frood1168/hackrf-pro/(list of files, drawings)

Other design files:
Altium/Imported praline/adc-dac.SchDoc
Altium/Imported praline/baseband.SchDoc
Altium/Imported praline/clock.SchDoc
Altium/Imported praline/fpga.SchDoc
Altium/Imported praline/frontend.SchDoc
Altium/Imported praline/image_reject.SchDoc
Altium/Imported praline/mcu.SchDoc
Altium/Imported praline/mcu_c18pf.SchDoc
Altium/Imported praline/mixer.SchDoc
Altium/Imported praline/power.SchDoc
Altium/Imported praline/praline1/praline.PcbLib
Altium/Imported praline/praline1/praline.SCHLIB
Altium/Imported praline/praline.PcbDoc
Altium/Imported praline/praline.PrjPcb
Altium/Imported praline/praline.SchDoc
Altium/Imported praline/switch_control.SchDoc
Altium/Imported praline/usb.SchDoc
Altium/Imported praline_01/adc-dac.SchDoc
Altium/Imported praline_01/baseband.SchDoc
Altium/Imported praline_01/clock.SchDoc
Altium/Imported praline_01/fpga.SchDoc
Altium/Imported praline_01/frontend.SchDoc
Altium/Imported praline_01/image_reject.SchDoc
Altium/Imported praline_01/mcu.SchDoc
Altium/Imported praline_01/mixer.SchDoc
Altium/Imported praline_01/power.SchDoc
Altium/Imported praline_01/praline-cache.SchLib
Altium/Imported praline_01/praline.PcbDoc
Altium/Imported praline_01/praline.PrjPcb
Altium/Imported praline_01/praline.SchDoc
Altium/Imported praline_01/praline.SchLib
Altium/Imported praline_01/switch_control.SchDoc
Altium/Imported praline_01/usb.SchDoc
