frood1168/hackrf-pro/adc-dac.kicad_sch

## KiCad design adc-dac.kicad_sch (2026-06-23)

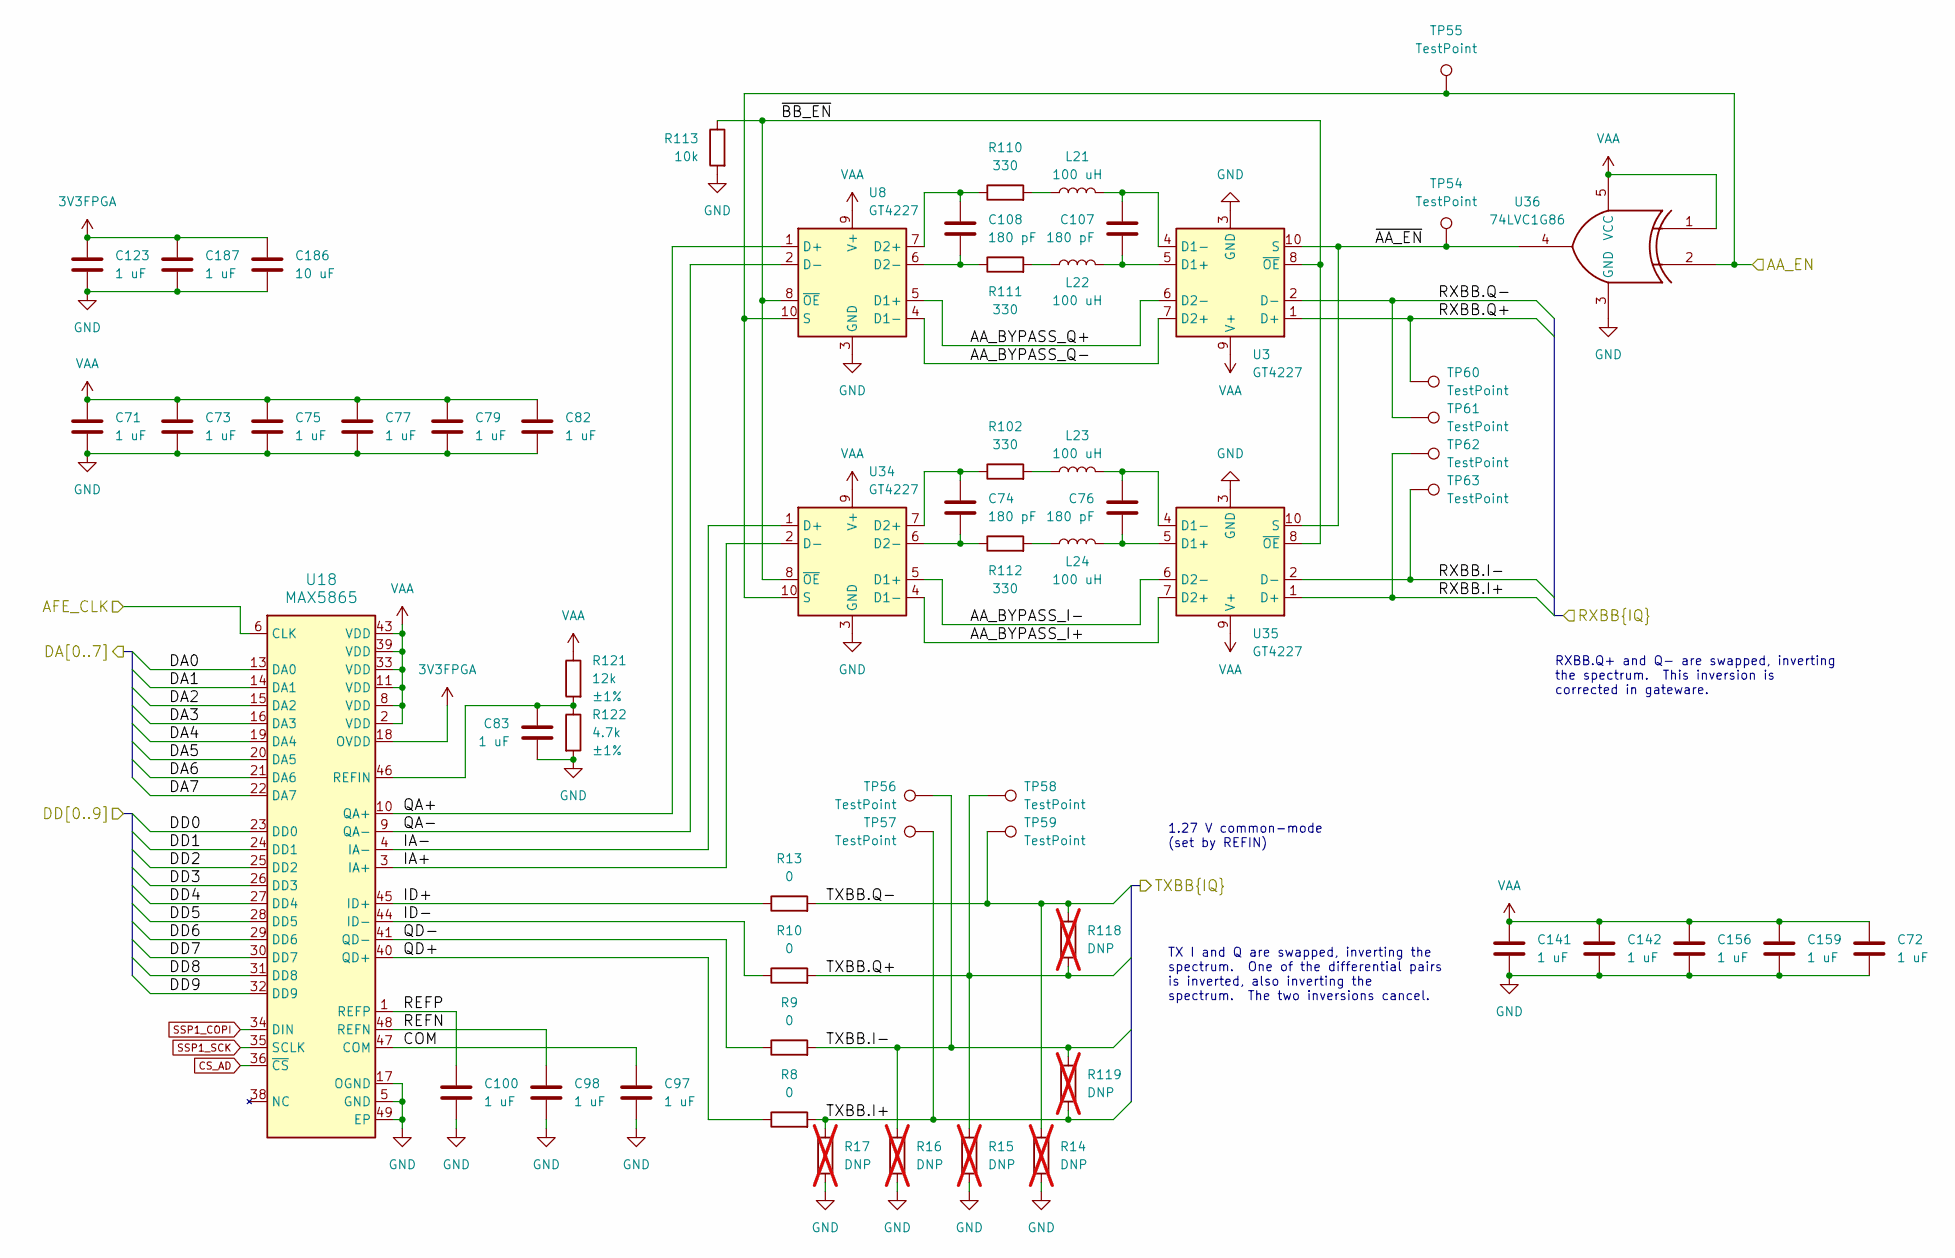
[picture p1: schematic adc-dac.kicad_sch]

Parts:
C71, C72, C73, C75, C77, C79, C82, C83, C97, C98, C100, C123, C141, C142, C156, C159, C187: 1 uF; C_0201_0603Metric; Part Number GRM033R61A105ME44D
C74, C76, C107, C108: 180 pF; C_0201_0603Metric; Part Number GRM0335C1H181JA01D
C186: 10 uF; C_0805_2012Metric; Part Number CL21A106KOQNNNE
L21, L22, L23, L24: 100 uH; L_TDK_MLZ2012_h1.25mm; Part Number MLZ2012N101LT000
R8, R9, R10, R13: 0; R_0201_0603Metric; Part Number RC0201JR-070RL
R14, R15, R16, R17, R118, R119: DNP; R_0201_0603Metric; not fitted
R102, R110, R111, R112: 330; R_0201_0603Metric; Part Number RC0201JR-07330RL
R113: 10k; R_0402_1005Metric; Part Number RC0402JR-0710KL
R121: 12k; R_0201_0603Metric; Tolerance ±1%; Part Number RC0201FR-0712KL
R122: 4.7k; R_0201_0603Metric; Tolerance ±1%; Part Number RC0201FR-074K7L
TP54, TP55, TP56, TP57, TP58, TP59, TP60, TP61, TP62, TP63: TestPoint; TestPoint_Pad_D1.0mm
U3, U8, U34, U35: GT4227; GTIC_UQFN-10_1.4x1.8mm_P0.4mm; Part Number GT4227QA
U18: MAX5865; QFN-48-1EP_7x7mm_P0.5mm_EP5.3x5.3mm_ThermalVias; Part Number MAX5865ETM+T
U36: 74LVC1G86; SOT-353_SC-70-5; Part Number SN74LVC1G86DCKR

Connections:
3V3FPGA: C123.1, C186.1, C187.1, U18.18 (OVDD)
AA_BYPASS_I+: U34.4 (D1-), U35.7 (D2+)
AA_BYPASS_I-: U34.5 (D1+), U35.6 (D2-)
AA_BYPASS_Q+: U3.6 (D2-), U8.5 (D1+)
AA_BYPASS_Q-: U3.7 (D2+), U8.4 (D1-)
AA_EN: TP55.1, U8.10 (S), U34.10 (S), U36.2
AFE_CLK: U18.6 (CLK)
COM: C97.1, U18.47 (COM)
CS_AD: U18.36 (~CS)
DA0: U18.13 (DA0)
DA1: U18.14 (DA1)
DA2: U18.15 (DA2)
DA3: U18.16 (DA3)
DA4: U18.19 (DA4)
DA5: U18.20 (DA5)
DA6: U18.21 (DA6)
DA7: U18.22 (DA7)
DD0: U18.23 (DD0)
DD1: U18.24 (DD1)
DD2: U18.25 (DD2)
DD3: U18.26 (DD3)
DD4: U18.27 (DD4)
DD5: U18.28 (DD5)
DD6: U18.29 (DD6)
DD7: U18.30 (DD7)
DD8: U18.31 (DD8)
DD9: U18.32 (DD9)
GND: C71.2, C72.2, C73.2, C75.2, C77.2, C79.2, C82.2, C83.2, C97.2, C98.2, C100.2, C123.2, C141.2, C142.2, C156.2, C159.2, C186.2, C187.2, R14.2, R15.2, R16.2, R17.2, R113.2, R122.2, U3.3 (GND), U8.3 (GND), U18.5 (GND), U18.7 (GND), U18.12 (GND), U18.17 (OGND), U18.37 (GND), U18.42 (GND), U18.49 (EP), U34.3 (GND), U35.3 (GND), U36.3 (GND)
IA+: U18.3 (IA+), U34.2 (D-)
IA-: U18.4 (IA-), U34.1 (D+)
ID+: R13.1, U18.45 (ID+)
ID-: R10.1, U18.44 (ID-)
unnamed: C74.1, R102.1, U34.7 (D2+)
unnamed: C74.2, R112.1, U34.6 (D2-)
unnamed: C76.1, L23.2, U35.4 (D1-)
unnamed: C76.2, L24.2, U35.5 (D1+)
unnamed: C83.1, R121.2, R122.1, U18.46 (REFIN)
unnamed: C107.1, L21.2, U3.4 (D1-)
unnamed: C107.2, L22.2, U3.5 (D1+)
unnamed: C108.1, R110.1, U8.7 (D2+)
unnamed: C108.2, R111.1, U8.6 (D2-)
unnamed: L21.1, R110.2
unnamed: L22.1, R111.2
unnamed: L23.1, R102.2
unnamed: L24.1, R112.2
QA+: U8.1 (D+), U18.10 (QA+)
QA-: U8.2 (D-), U18.9 (QA-)
QD+: R8.1, U18.40 (QD+)
QD-: R9.1, U18.41 (QD-)
REFN: C98.1, U18.48 (REFN)
REFP: C100.1, U18.1 (REFP)
RXBB.I+: TP62.1, U35.1 (D+)
RXBB.I-: TP63.1, U35.2 (D-)
RXBB.Q+: TP60.1, U3.1 (D+)
RXBB.Q-: TP61.1, U3.2 (D-)
SSP1_COPI: U18.34 (DIN)
SSP1_SCK: U18.35 (SCLK)
TXBB.I+: R8.2, R17.1, R119.2, TP57.1
TXBB.I-: R9.2, R16.1, R119.1, TP56.1
TXBB.Q+: R10.2, R15.1, R118.2, TP58.1
TXBB.Q-: R13.2, R14.1, R118.1, TP59.1
VAA: C71.1, C72.1, C73.1, C75.1, C77.1, C79.1, C82.1, C141.1, C142.1, C156.1, C159.1, R121.1, U3.9 (V+), U8.9 (V+), U18.2 (VDD), U18.8 (VDD), U18.11 (VDD), U18.33 (VDD), U18.39 (VDD), U18.43 (VDD), U34.9 (V+), U35.9 (V+), U36.1, U36.5 (VCC)
~AA_EN: TP54.1, U3.10 (S), U35.10 (S), U36.4
~BB_EN: R113.1, U3.8 (~OE), U8.8 (~OE), U34.8 (~OE), U35.8 (~OE)

Notes on the sheet:
1.27 V common-mode (set by REFIN)
RXBB.Q+ and Q- are swapped, inverting the spectrum. This inversion is corrected in gateware.
TX I and Q are swapped, inverting the spectrum. One of the differential pairs is inverted, also inverting the spectrum. The two inversions cancel.
