frood1168/hackrf-pro/baseband.kicad_sch

## KiCad design baseband.kicad_sch (2026-06-23)

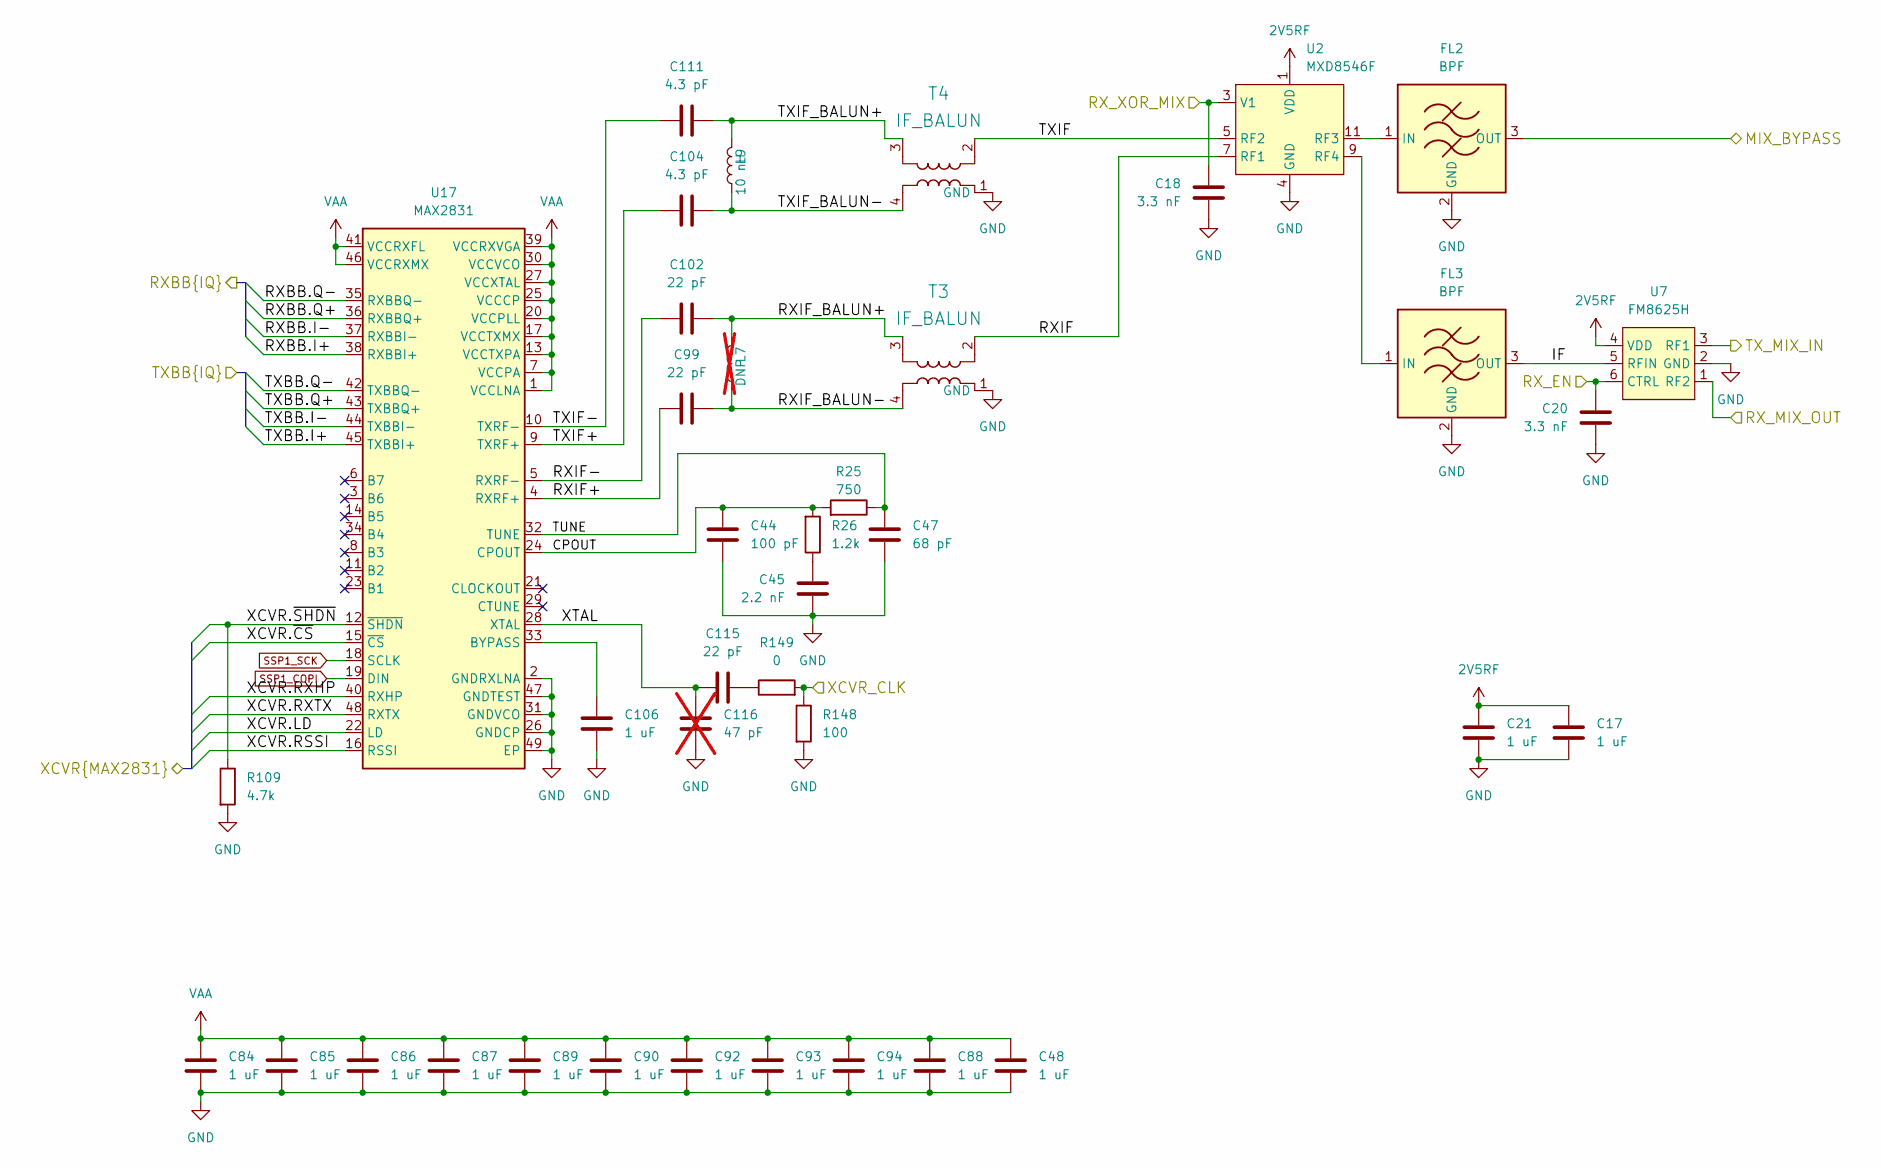
[picture p2: schematic baseband.kicad_sch]

Parts:
C17, C21, C48, C84, C85, C86, C87, C88, C89, C90, C92, C93, C94, C106: 1 uF; C_0201_0603Metric; Part Number GRM033R61A105ME44D
C18, C20: 3.3 nF; C_0201_0603Metric; Part Number GRM033R71A332KA01D
C44: 100 pF; C_0201_0603Metric; Part Number GRM0335C1E101JA01D
C45: 2.2 nF; C_0201_0603Metric; Part Number GRM033R71A222KA01D
C47: 68 pF; C_0201_0603Metric; Part Number GRM0335C1H680JA01D
C99, C102, C115: 22 pF; C_0201_0603Metric; Part Number GRM0335C1H220JA01D
C104, C111: 4.3 pF; C_0201_0603Metric; Part Number GRM0335C1E4R3CA01D
C116: 47 pF; C_0201_0603Metric; Part Number GRM0335C1E470JA01D; not fitted
FL2, FL3: BPF; Filter_Pulse_BPF1608LM09R5000A; Part Number BPF1608LM02R2400A
L7: DNP; L_0201_0603Metric; not fitted
L9: 10 nH; L_0201_0603Metric; Part Number LQP03TN10NJ02D
R25: 750; R_0201_0603Metric; Part Number RC0201JR-07750RL
R26: 1.2k; R_0201_0603Metric; Part Number RC0201JR-071K2L
R109: 4.7k; R_0201_0603Metric; Part Number RC0201FR-074K7L
R148: 100; R_0201_0603Metric; Part Number RC0201JR-07100RL
R149: 0; R_0201_0603Metric; Part Number RC0201JR-070RL
T3, T4: IF_BALUN; Balun_TDK_TFSZ06052460-3310A2X; Part Number TFSZ06052460-3310A2X
U2: MXD8546F; QFN-12-1EP_2x2mm_P0.5mm_EP1x1mm; Part Number MXD8546F
U7: FM8625H; TSLP-6-4_1.1x0.7mm_P0.4mm; Part Number FM8625H
U17: MAX2831; QFN-48-1EP_7x7mm_P0.5mm_EP5.6x5.6mm_ThermalVias; Part Number MAX2831ETM+T

Connections:
2V5RF: C17.1, C21.1, U2.1 (VDD), U7.4 (VDD)
CPOUT: C44.2, R25.2, R26.2, U17.24 (CPOUT)
GND: C17.2, C18.1, C20.1, C21.2, C44.1, C45.1, C47.1, C48.2, C84.2, C85.2, C86.2, C87.2, C88.2, C89.2, C90.2, C92.2, C93.2, C94.2, C106.2, C116.2, FL2.2 (GND), FL2.4 (GND), FL3.2 (GND), FL3.4 (GND), R109.2, R148.2, T3.1 (GND), T4.1 (GND), U2.4 (GND), U2.6 (GND), U2.10 (GND), U2.12 (GND), U2.13 (GND), U7.2 (GND), U17.2 (GNDRXLNA), U17.26 (GNDCP), U17.31 (GNDVCO), U17.47 (GNDTEST), U17.49 (EP)
IF: FL3.3 (OUT), U7.5 (RFIN)
MIX_BYPASS: FL2.3 (OUT)
unnamed: C45.2, R26.1
unnamed: C106.1, U17.33 (BYPASS)
unnamed: C115.1, R149.1
unnamed: FL2.1 (IN), U2.11 (RF3)
unnamed: FL3.1 (IN), U2.9 (RF4)
RXBB.I+: U17.38 (RXBBI+)
RXBB.I-: U17.37 (RXBBI-)
RXBB.Q+: U17.36 (RXBBQ+)
RXBB.Q-: U17.35 (RXBBQ-)
RXIF: T3.2, U2.7 (RF1)
RXIF+: C99.1, U17.4 (RXRF+)
RXIF-: C102.1, U17.5 (RXRF-)
RXIF_BALUN+: C102.2, L7.1, T3.3
RXIF_BALUN-: C99.2, L7.2, T3.4
RX_EN: C20.2, U7.6 (CTRL)
RX_MIX_OUT: U7.1 (RF2)
RX_XOR_MIX: C18.2, U2.3 (V1)
SSP1_COPI: U17.19 (DIN)
SSP1_SCK: U17.18 (SCLK)
TUNE: C47.2, R25.1, U17.32 (TUNE)
TXBB.I+: U17.45 (TXBBI+)
TXBB.I-: U17.44 (TXBBI-)
TXBB.Q+: U17.43 (TXBBQ+)
TXBB.Q-: U17.42 (TXBBQ-)
TXIF: T4.2, U2.5 (RF2)
TXIF+: C104.1, U17.9 (TXRF+)
TXIF-: C111.1, U17.10 (TXRF-)
TXIF_BALUN+: C111.2, L9.1, T4.3
TXIF_BALUN-: C104.2, L9.2, T4.4
TX_MIX_IN: U7.3 (RF1)
VAA: C48.1, C84.1, C85.1, C86.1, C87.1, C88.1, C89.1, C90.1, C92.1, C93.1, C94.1, U17.1 (VCCLNA), U17.7 (VCCPA), U17.13 (VCCTXPA), U17.17 (VCCTXMX), U17.20 (VCCPLL), U17.25 (VCCCP), U17.27 (VCCXTAL), U17.30 (VCCVCO), U17.39 (VCCRXVGA), U17.41 (VCCRXFL), U17.46 (VCCRXMX)
XCVR.LD: U17.22 (LD)
XCVR.RSSI: U17.16 (RSSI)
XCVR.RXHP: U17.40 (RXHP)
XCVR.RXTX: U17.48 (RXTX)
XCVR.~CS: U17.15 (~CS)
XCVR.~SHDN: R109.1, U17.12 (~SHDN)
XCVR_CLK: R148.1, R149.2
XTAL: C115.2, C116.1, U17.28 (XTAL)
