frood1168/hackrf-pro/clock.kicad_sch

## KiCad design clock.kicad_sch (2026-06-23)

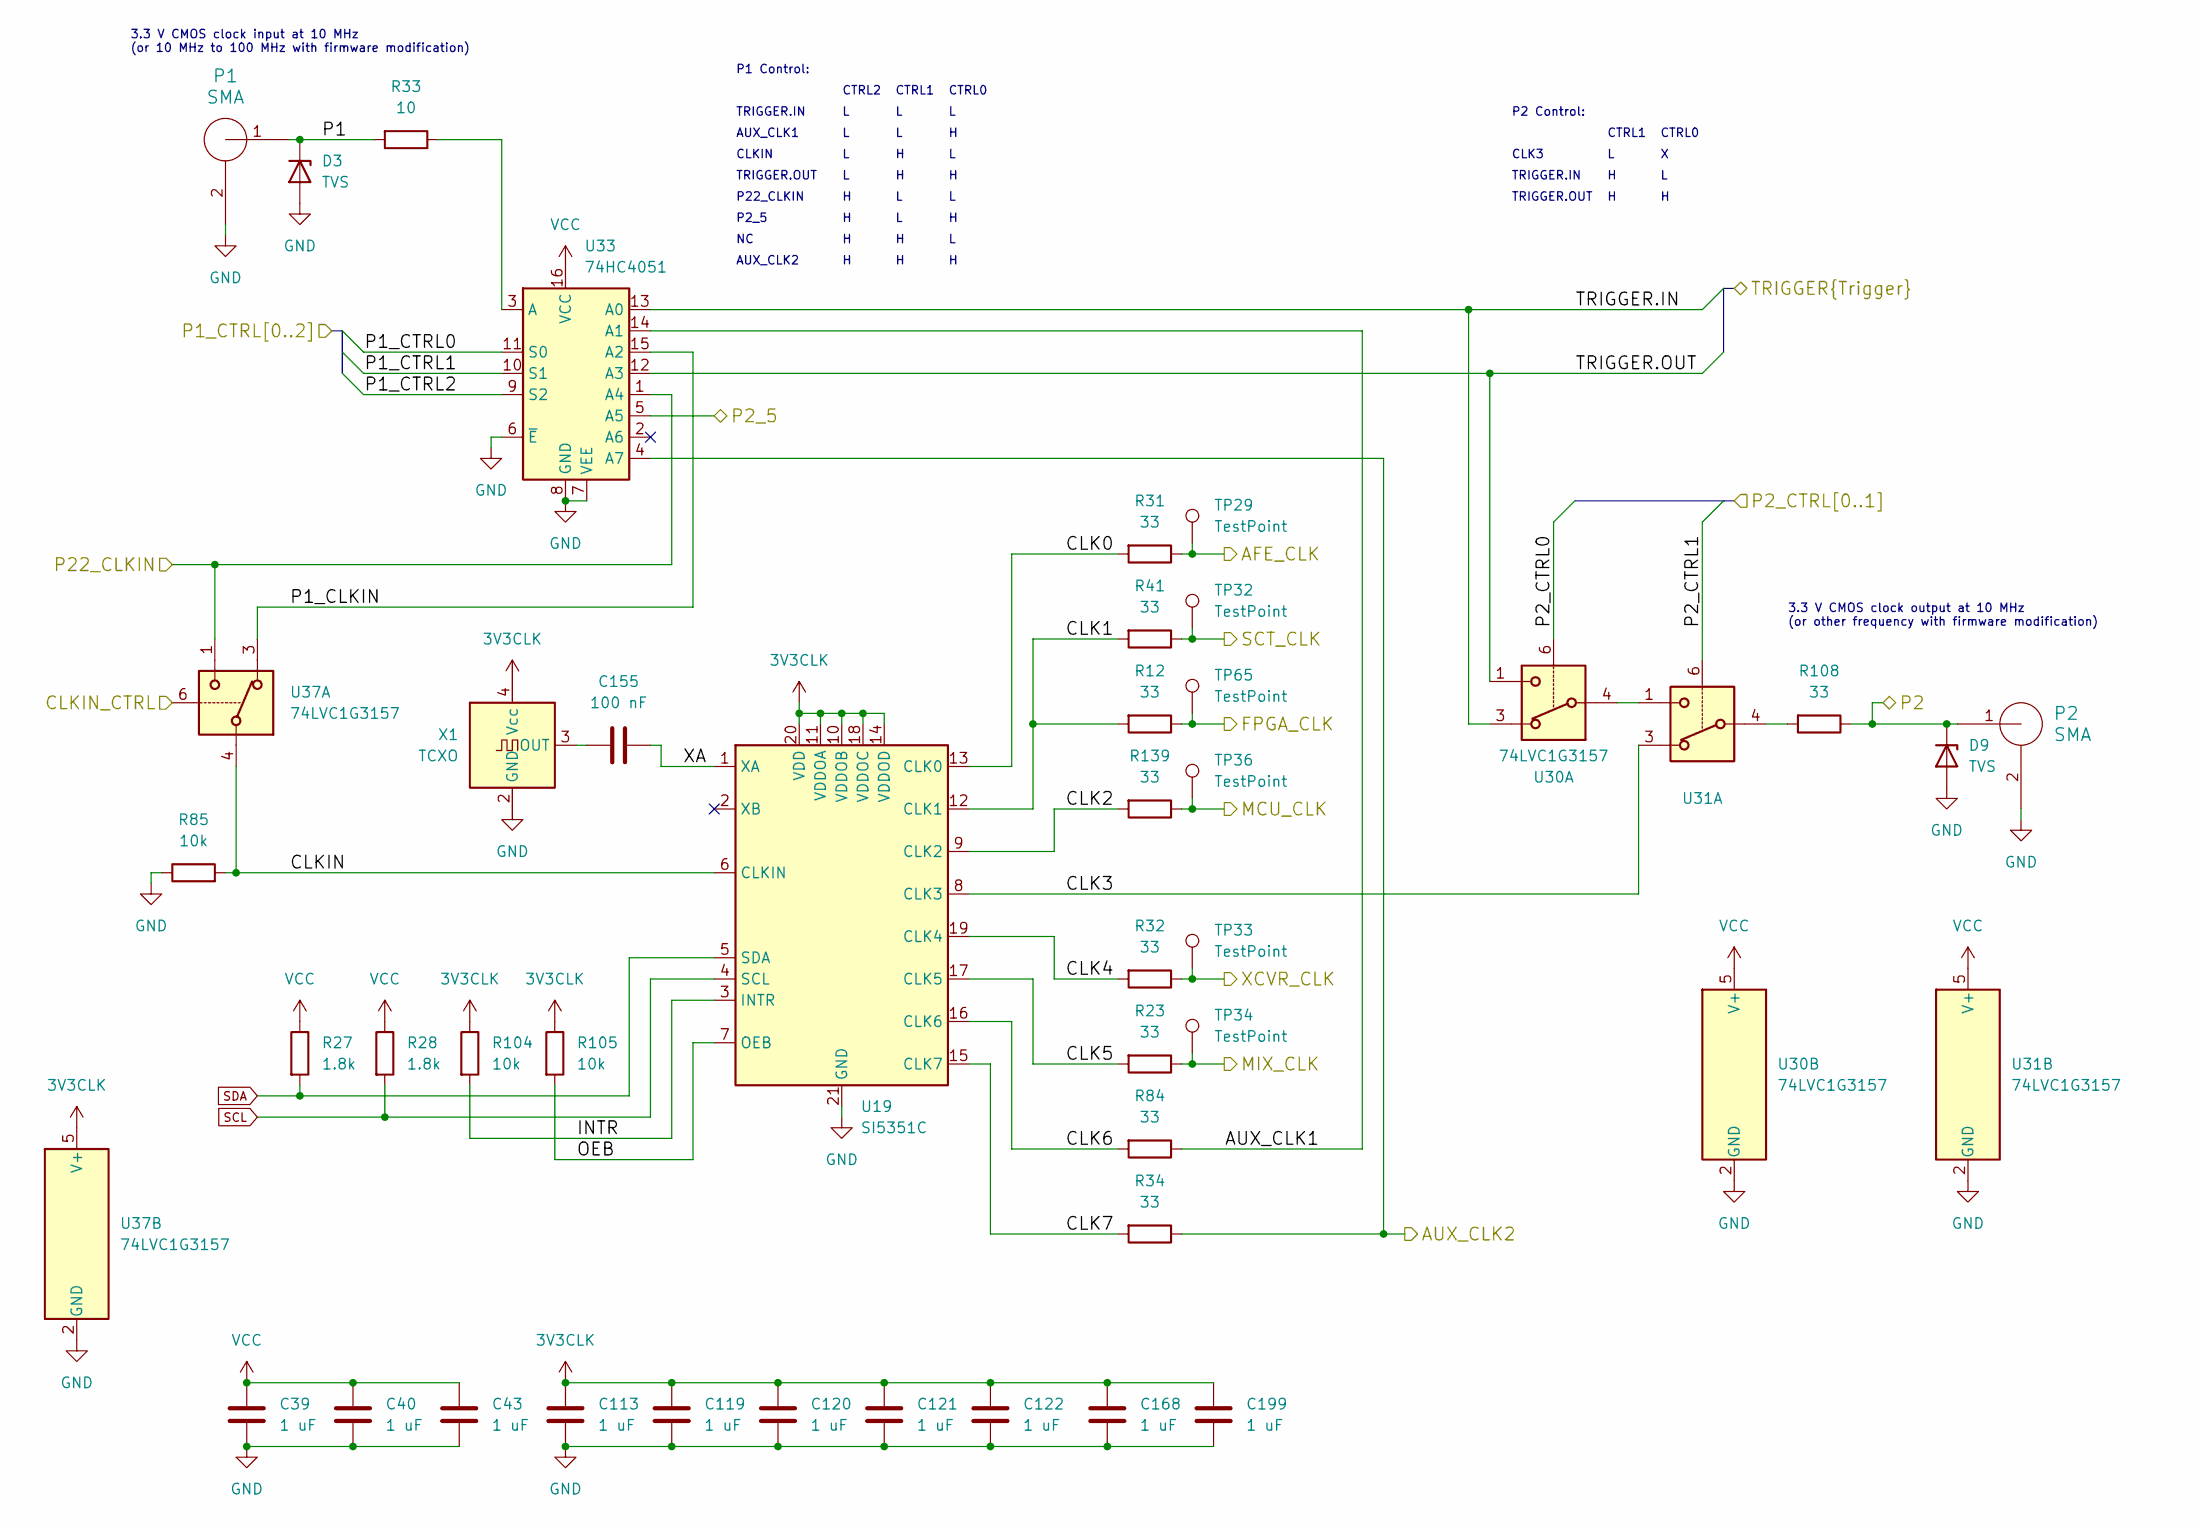
[picture p3: schematic clock.kicad_sch]

Parts:
C39, C40, C43, C113, C119, C120, C121, C122, C168, C199: 1 uF; C_0402_1005Metric; Part Number CL05A105KA5NQNC
C155: 100 nF; C_0402_1005Metric; Part Number CL05A104KA5NNNC
D3, D9: TVS; TSLP-2-19; Part Number SLESD0301L
P1, P2: SMA; SMA_MyAntenna_A-SMA-KE-16.5A_EdgeMount; Part Number A-SMA-KE-16.5A
R12, R23, R31, R32, R34, R41, R84, R108, R139: 33; R_0201_0603Metric; Part Number RC0201JR-0733RL
R27, R28: 1.8k; R_0402_1005Metric; Part Number RC0402JR-071K8L
R33: 10; R_0201_0603Metric; Part Number RC0201JR-0710RL
R85, R104, R105: 10k; R_0402_1005Metric; Part Number RC0402JR-0710KL
TP29, TP32, TP33, TP34, TP36, TP65: TestPoint; TestPoint_Pad_D1.0mm
U19: SI5351C; QFN-20-1EP_4x4mm_P0.5mm_EP2.7x2.7mm_ThermalVias; Part Number SI5351C-B-GM
U30, U31, U37: 74LVC1G3157; SOT-363_SC-70-6; Part Number ET3157
U33: 74HC4051; DHVQFN-16-1EP_2.5x3.5mm_P0.5mm_EP1x2mm; Part Number 74HC4051BQ,115
X1: TCXO; Oscillator_SMD_SeikoEpson_TG2520SMN-xxx-xxxxxx-4Pin_2.5x2.0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; Part Number 8122S-25.000NQ33FTL

Connections:
3V3CLK: C113.1, C119.1, C120.1, C121.1, C122.1, C168.2, C199.1, R104.1, R105.1, U19.10 (VDDOB), U19.11 (VDDOA), U19.14 (VDDOD), U19.18 (VDDOC), U19.20 (VDD), U37.5 (V+), X1.4 (Vcc)
AFE_CLK: R31.1, TP29.1
AUX_CLK1: R84.1, U33.14 (A1)
AUX_CLK2: R34.1, U33.4 (A7)
CLK0: R31.2, U19.13 (CLK0)
CLK1: R12.2, R41.2, U19.12 (CLK1)
CLK2: R139.2, U19.9 (CLK2)
CLK3: U19.8 (CLK3), U31.3
CLK4: R32.2, U19.19 (CLK4)
CLK5: R23.2, U19.17 (CLK5)
CLK6: R84.2, U19.16 (CLK6)
CLK7: R34.2, U19.15 (CLK7)
CLKIN: R85.2, U19.6 (CLKIN), U37.4
CLKIN_CTRL: U37.6
FPGA_CLK: R12.1, TP65.1
GND: C39.2, C40.2, C43.2, C113.2, C119.2, C120.2, C121.2, C122.2, C168.1, C199.2, D3.2 (A), D9.2 (A), P1.2 (GND), P2.2 (GND), R85.1, U19.21 (GND), U30.2 (GND), U31.2 (GND), U33.6 (~E), U33.7 (VEE), U33.8 (GND), U37.2 (GND), X1.2 (GND)
INTR: R104.2, U19.3 (INTR)
MCU_CLK: R139.1, TP36.1
MIX_CLK: R23.1, TP34.1
unnamed: C155.2, X1.3 (OUT)
unnamed: R33.1, U33.3 (A)
unnamed: R108.2, U31.4
unnamed: U30.4, U31.1
OEB: R105.2, U19.7 (OEB)
P1: D3.1 (K), P1.1 (RF), R33.2
P1_CLKIN: U33.15 (A2), U37.3
P1_CTRL0: U33.11 (S0)
P1_CTRL1: U33.10 (S1)
P1_CTRL2: U33.9 (S2)
P2: D9.1 (K), P2.1 (RF), R108.1
P2_5: U33.5 (A5)
P2_CTRL0: U30.6
P2_CTRL1: U31.6
P22_CLKIN: U33.1 (A4), U37.1
SCL: R28.2, U19.4 (SCL)
SCT_CLK: R41.1, TP32.1
SDA: R27.2, U19.5 (SDA)
TRIGGER.IN: U30.3, U33.13 (A0)
TRIGGER.OUT: U30.1, U33.12 (A3)
VCC: C39.1, C40.1, C43.1, R27.1, R28.1, U30.5 (V+), U31.5 (V+), U33.16 (VCC)
XA: C155.1, U19.1 (XA)
XCVR_CLK: R32.1, TP33.1

Notes on the sheet:
TRIGGER.OUT
CLK3
P2_5
TRIGGER.IN
3.3 V CMOS clock output at 10 MHz (or other frequency with firmware modification)
AUX_CLK1
CTRL0
AUX_CLK2
3.3 V CMOS clock input at 10 MHz (or 10 MHz to 100 MHz with firmware modification)
P22_CLKIN
CTRL1
CTRL2
P1 Control:
CLKIN
P2 Control:
