frood1168/hackrf-pro/fpga.kicad_sch

## KiCad design fpga.kicad_sch (2026-06-23)

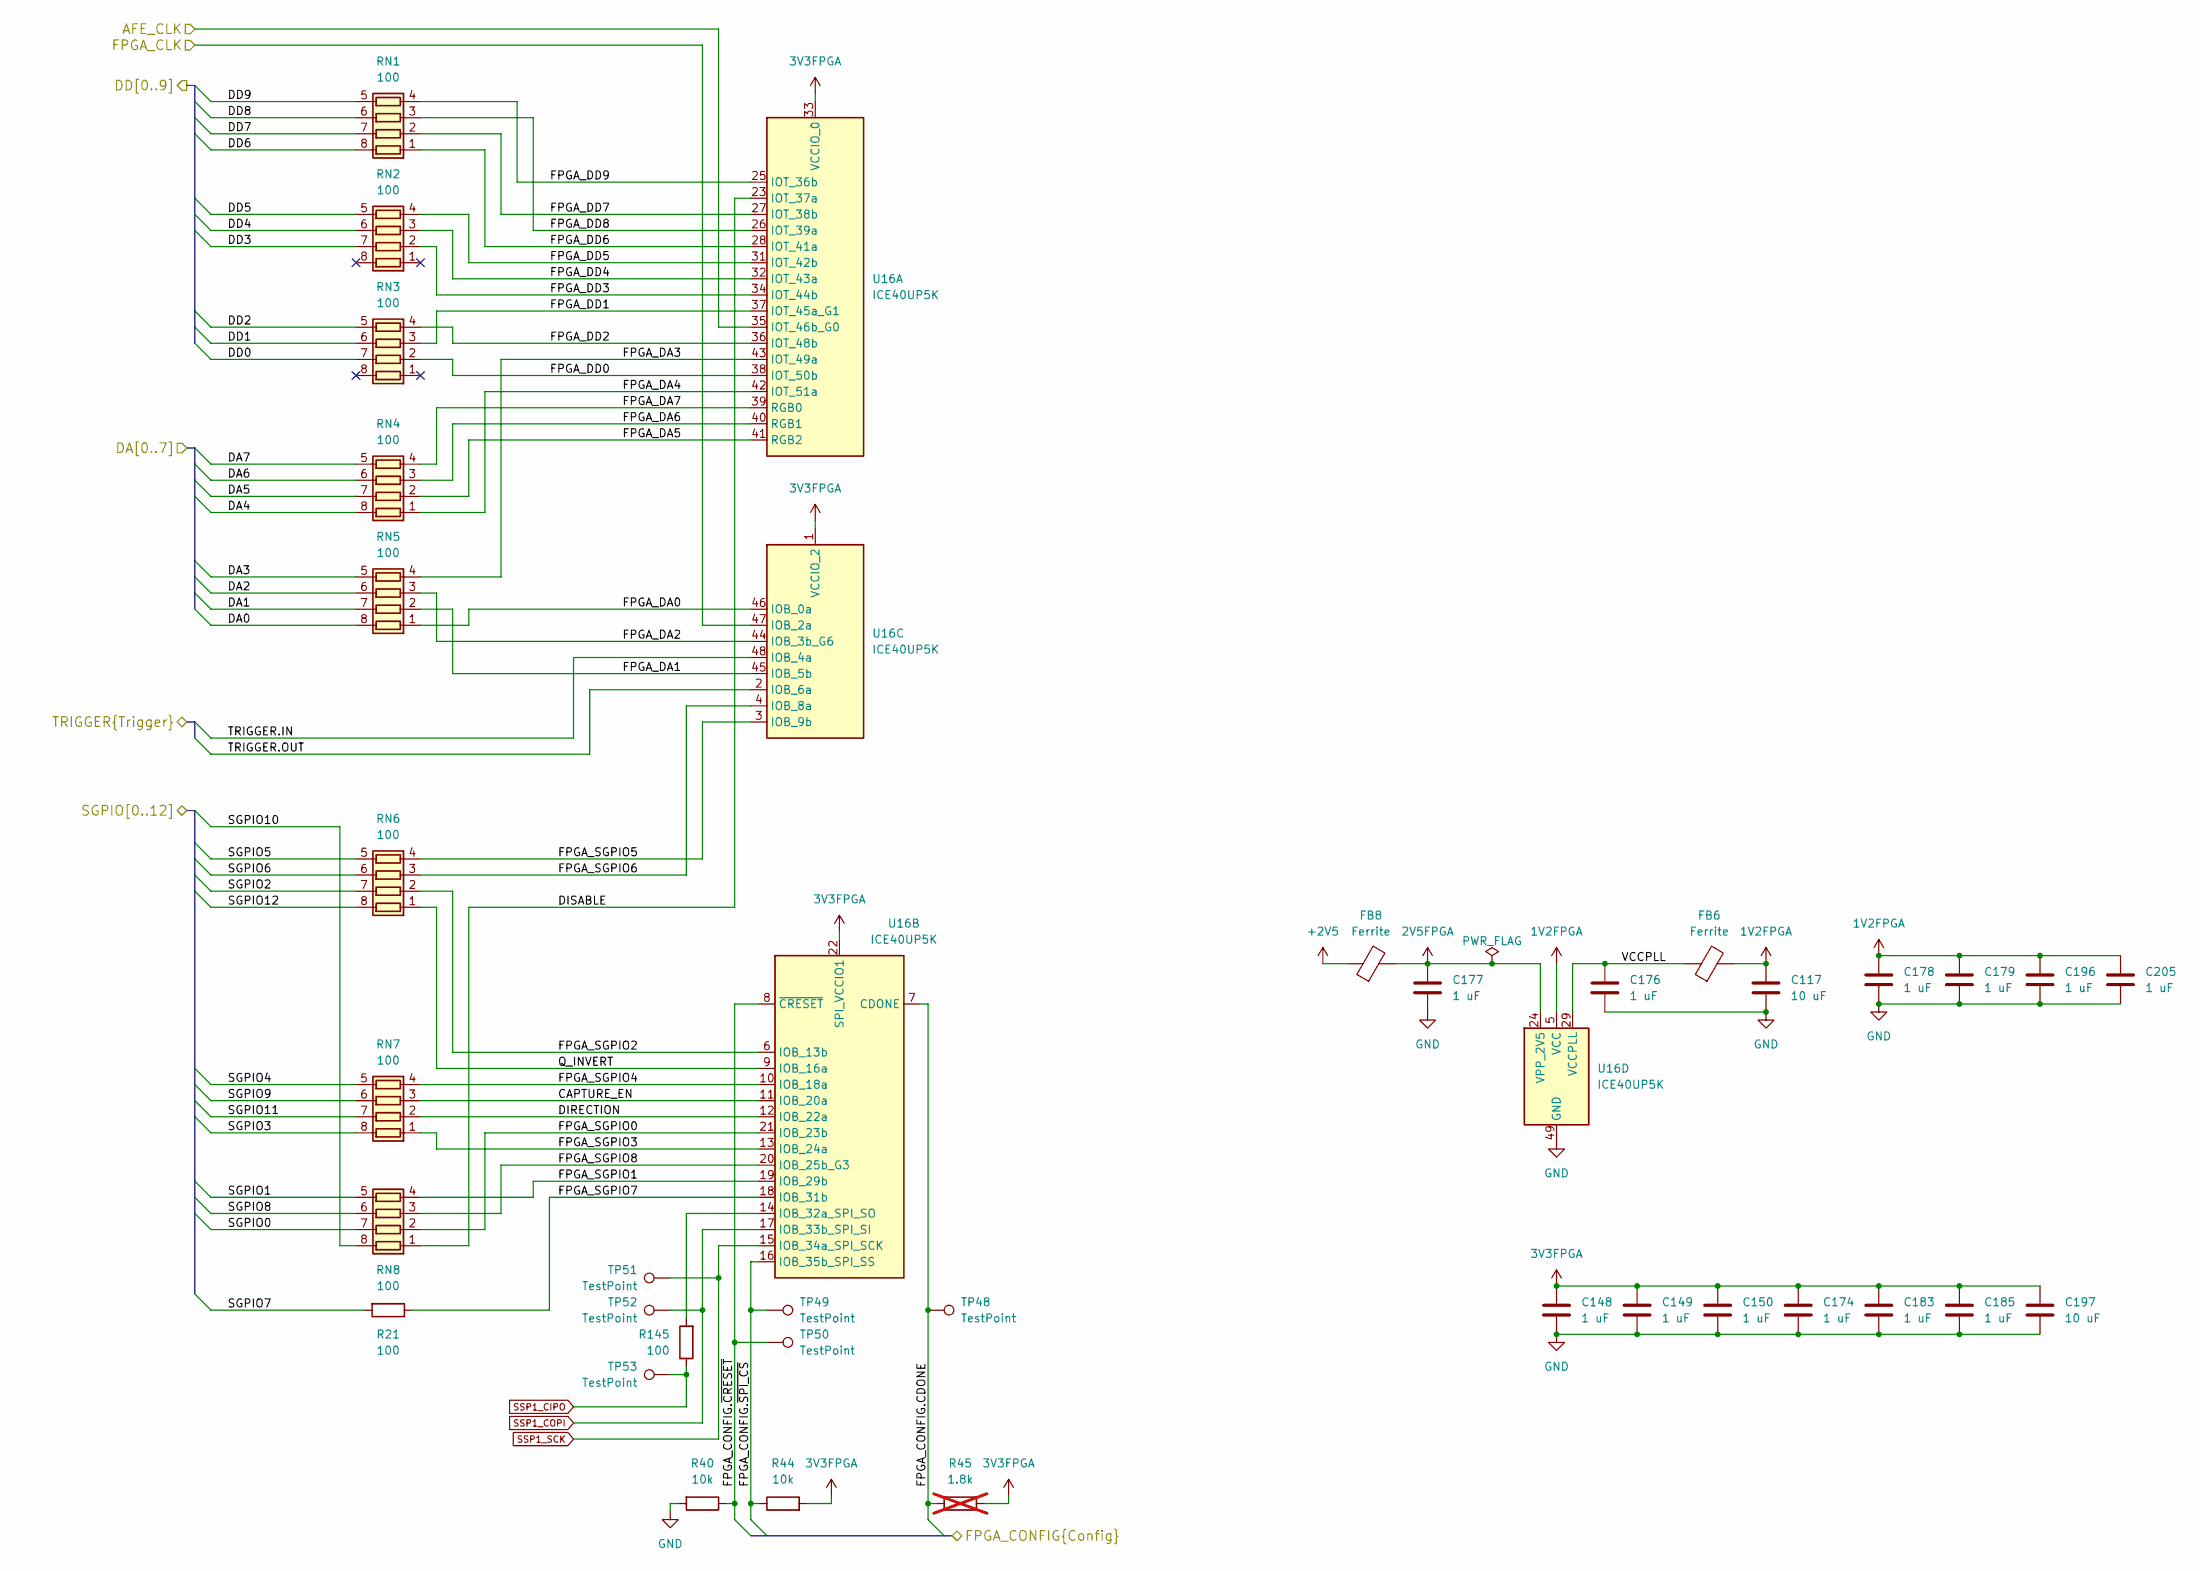
[picture p4: schematic fpga.kicad_sch]

Parts:
C117, C197: 10 uF; C_0805_2012Metric; Part Number CL21A106KOQNNNE
C148, C149, C150, C174, C176, C177, C178, C179, C183, C185, C196, C205: 1 uF; C_0201_0603Metric; Part Number GRM033R61A105ME44D
FB6, FB8: Ferrite; L_0603_1608Metric; Part Number HCB1608KF-102T10
R21, R145: 100; R_0201_0603Metric; Part Number RC0201JR-07100RL
R40, R44: 10k; R_0402_1005Metric; Part Number RC0402JR-0710KL
R45: 1.8k; R_0402_1005Metric; Part Number RC0402JR-071K8L; not fitted
RN1, RN2, RN3, RN4, RN5, RN6, RN7, RN8: 100; R_Array_Convex_4x0402; Part Number YC124-JR-07100RL
TP48, TP49, TP50, TP51, TP52, TP53: TestPoint; TestPoint_Pad_D1.0mm
U16: ICE40UP5K; QFN-48-1EP_7x7mm_P0.5mm_EP5.6x5.6mm_ThermalVias; Part Number ICE40UP5K-SG48ITR

Connections:
1V2FPGA: C117.1, C178.1, C179.1, C196.1, C205.1, FB6.2, U16.5 (VCC), U16.30 (VCC)
2V5FPGA: C177.1, FB8.2, U16.24 (VPP_2V5)
3V3FPGA: C148.1, C149.1, C150.1, C174.1, C183.1, C185.1, C197.1, R44.2, R45.2, U16.1 (VCCIO_2), U16.22 (SPI_VCCIO1), U16.33 (VCCIO_0)
+2V5: FB8.1
AFE_CLK: U16.35 (IOT_46b_G0)
CAPTURE_EN: RN7.3 (R3.1), U16.11 (IOB_20a)
DA0: RN5.8 (R1.2)
DA1: RN5.7 (R2.2)
DA2: RN5.6 (R3.2)
DA3: RN5.5 (R4.2)
DA4: RN4.8 (R1.2)
DA5: RN4.7 (R2.2)
DA6: RN4.6 (R3.2)
DA7: RN4.5 (R4.2)
DD0: RN3.7 (R2.2)
DD1: RN3.6 (R3.2)
DD2: RN3.5 (R4.2)
DD3: RN2.7 (R2.2)
DD4: RN2.6 (R3.2)
DD5: RN2.5 (R4.2)
DD6: RN1.8 (R1.2)
DD7: RN1.7 (R2.2)
DD8: RN1.6 (R3.2)
DD9: RN1.5 (R4.2)
DIRECTION: RN7.2 (R2.1), U16.12 (IOB_22a)
DISABLE: RN8.1 (R1.1), U16.23 (IOT_37a)
FPGA_CLK: U16.47 (IOB_2a)
FPGA_CONFIG.CDONE: R45.1, TP48.1, U16.7 (CDONE)
FPGA_CONFIG.~CRESET: R40.1, TP50.1, U16.8 (~CRESET)
FPGA_CONFIG.~SPI_CS: R44.1, TP49.1, U16.16 (IOB_35b_SPI_SS)
FPGA_DA0: RN5.1 (R1.1), U16.46 (IOB_0a)
FPGA_DA1: RN5.2 (R2.1), U16.45 (IOB_5b)
FPGA_DA2: RN5.3 (R3.1), U16.44 (IOB_3b_G6)
FPGA_DA3: RN5.4 (R4.1), U16.43 (IOT_49a)
FPGA_DA4: RN4.1 (R1.1), U16.42 (IOT_51a)
FPGA_DA5: RN4.2 (R2.1), U16.41 (RGB2)
FPGA_DA6: RN4.3 (R3.1), U16.40 (RGB1)
FPGA_DA7: RN4.4 (R4.1), U16.39 (RGB0)
FPGA_DD0: RN3.2 (R2.1), U16.38 (IOT_50b)
FPGA_DD1: RN3.3 (R3.1), U16.37 (IOT_45a_G1)
FPGA_DD2: RN3.4 (R4.1), U16.36 (IOT_48b)
FPGA_DD3: RN2.2 (R2.1), U16.34 (IOT_44b)
FPGA_DD4: RN2.3 (R3.1), U16.32 (IOT_43a)
FPGA_DD5: RN2.4 (R4.1), U16.31 (IOT_42b)
FPGA_DD6: RN1.1 (R1.1), U16.28 (IOT_41a)
FPGA_DD7: RN1.2 (R2.1), U16.27 (IOT_38b)
FPGA_DD8: RN1.3 (R3.1), U16.26 (IOT_39a)
FPGA_DD9: RN1.4 (R4.1), U16.25 (IOT_36b)
FPGA_SGPIO0: RN8.2 (R2.1), U16.21 (IOB_23b)
FPGA_SGPIO1: RN8.4 (R4.1), U16.19 (IOB_29b)
FPGA_SGPIO2: RN6.2 (R2.1), U16.6 (IOB_13b)
FPGA_SGPIO3: RN7.1 (R1.1), U16.13 (IOB_24a)
FPGA_SGPIO4: RN7.4 (R4.1), U16.10 (IOB_18a)
FPGA_SGPIO5: RN6.4 (R4.1), U16.3 (IOB_9b)
FPGA_SGPIO6: RN6.3 (R3.1), U16.4 (IOB_8a)
FPGA_SGPIO7: R21.1, U16.18 (IOB_31b)
FPGA_SGPIO8: RN8.3 (R3.1), U16.20 (IOB_25b_G3)
GND: C117.2, C148.2, C149.2, C150.2, C174.2, C176.2, C177.2, C178.2, C179.2, C183.2, C185.2, C196.2, C197.2, C205.2, R40.2, U16.49 (GND)
unnamed: R145.2, U16.14 (IOB_32a_SPI_SO)
Q_INVERT: RN6.1 (R1.1), U16.9 (IOB_16a)
SGPIO0: RN8.7 (R2.2)
SGPIO1: RN8.5 (R4.2)
SGPIO2: RN6.7 (R2.2)
SGPIO3: RN7.8 (R1.2)
SGPIO4: RN7.5 (R4.2)
SGPIO5: RN6.5 (R4.2)
SGPIO6: RN6.6 (R3.2)
SGPIO7: R21.2
SGPIO8: RN8.6 (R3.2)
SGPIO9: RN7.6 (R3.2)
SGPIO10: RN8.8 (R1.2)
SGPIO11: RN7.7 (R2.2)
SGPIO12: RN6.8 (R1.2)
SSP1_CIPO: R145.1, TP53.1
SSP1_COPI: TP52.1, U16.17 (IOB_33b_SPI_SI)
SSP1_SCK: TP51.1, U16.15 (IOB_34a_SPI_SCK)
TRIGGER.IN: U16.48 (IOB_4a)
TRIGGER.OUT: U16.2 (IOB_6a)
VCCPLL: C176.1, FB6.1, U16.29 (VCCPLL)
