frood1168/hackrf-pro/frontend.kicad_sch

## KiCad design frontend.kicad_sch (2026-06-23)

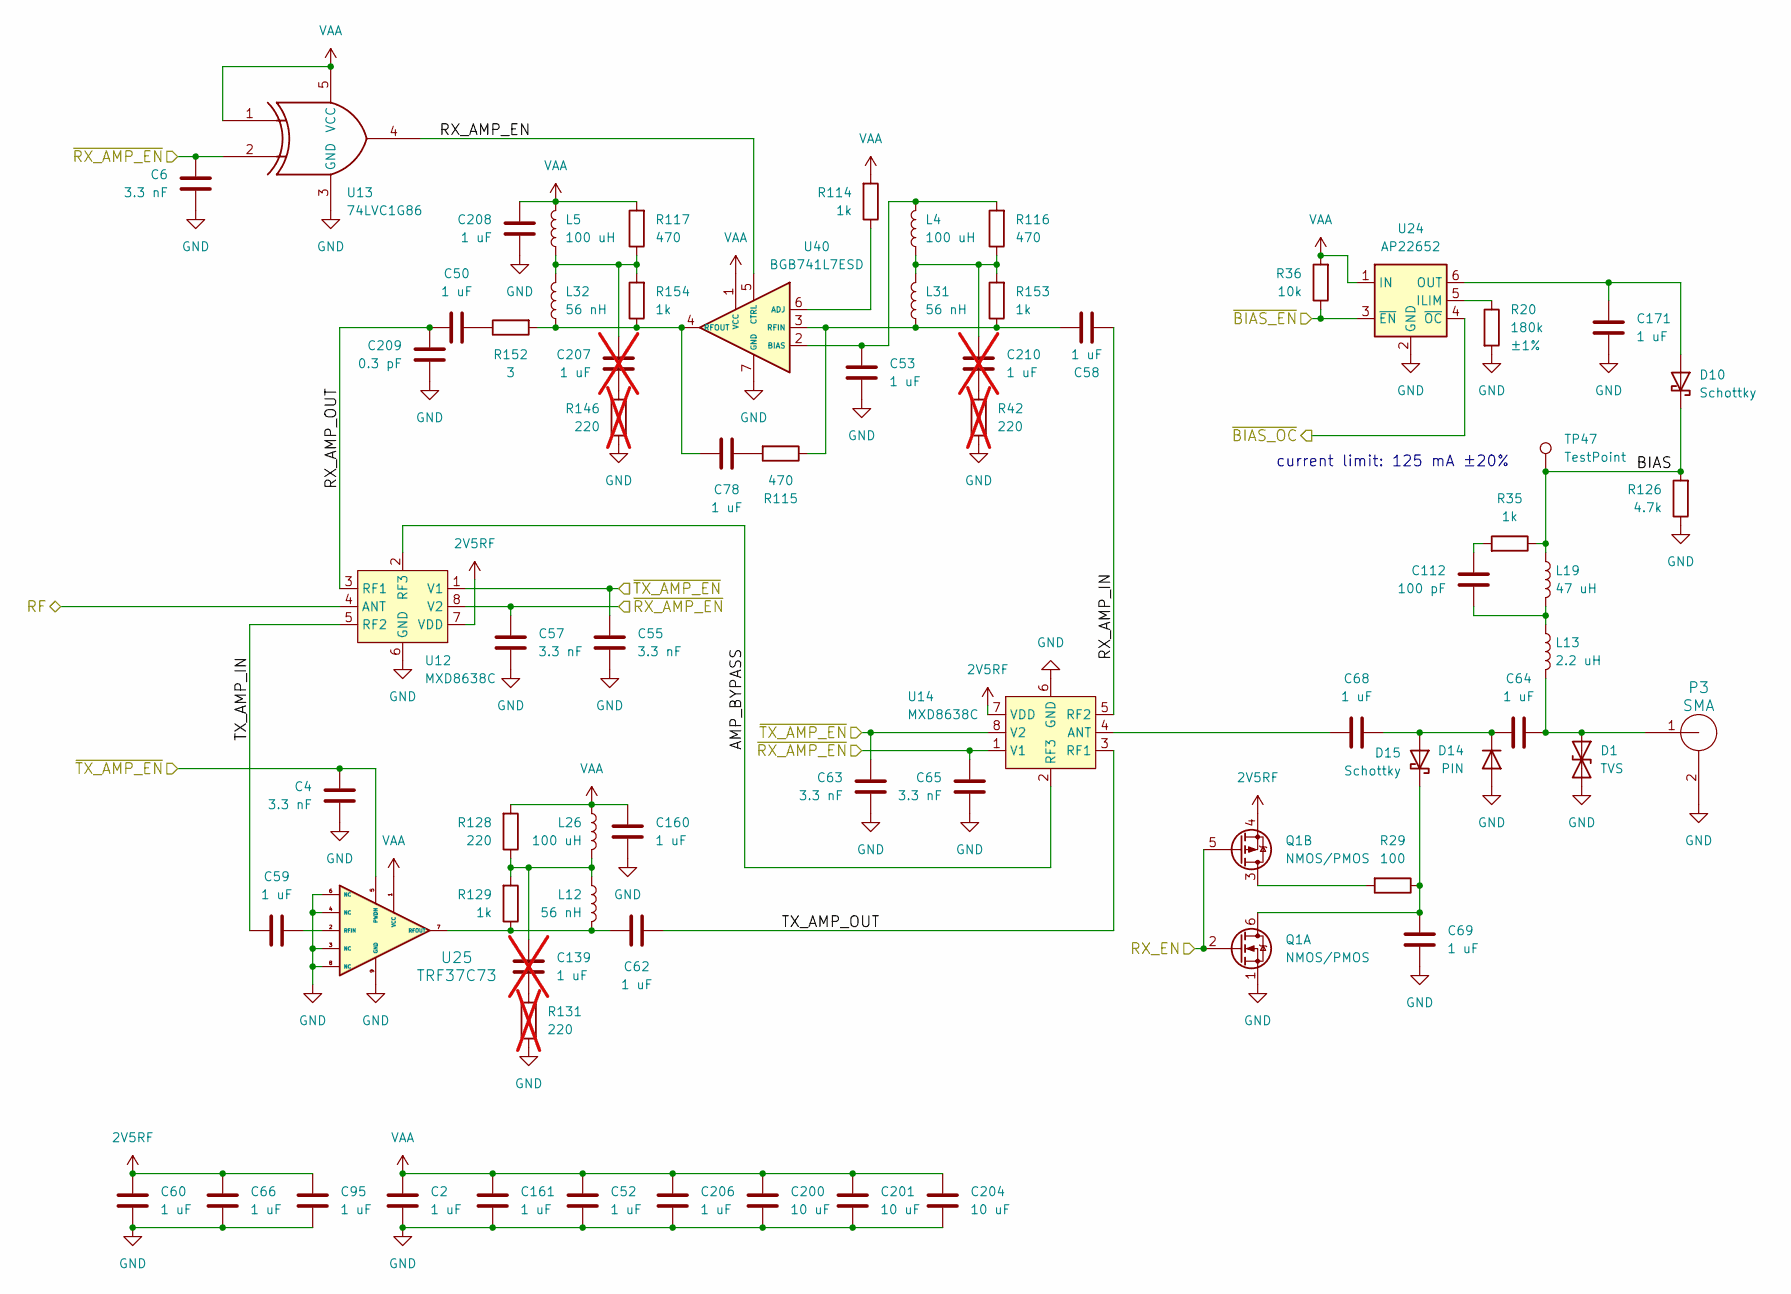
[picture p5: schematic frontend.kicad_sch]

Parts:
C2, C50, C52, C53, C58, C59, C60, C62, C66, C68, C69, C78, C95, C160, C161, C206, C208: 1 uF; C_0201_0603Metric; Part Number GRM033R61A105ME44D
C4, C6, C55, C57, C63, C65: 3.3 nF; C_0201_0603Metric; Part Number GRM033R71A332KA01D
C64, C171: 1 uF; C_0402_1005Metric; Part Number CL05A105KA5NQNC
C112: 100 pF; C_0201_0603Metric; Part Number GRM0335C1E101JA01D
C139, C207, C210: 1 uF; C_0201_0603Metric; Part Number GRM033R61A105ME44D; not fitted
C200, C201, C204: 10 uF; C_0805_2012Metric; Part Number CL21A106KOQNNNE
C209: 0.3 pF; C_0201_0603Metric; Part Number GRM0335C1ER30BA01D
D1: TVS; TSSLP-2-1; Part Number PESD5V0H1BSFYL
D10: Schottky; TSLP-2-19; Part Number PMEG4010ESBYL
D14: PIN; TSLP-2-19; Part Number BAR9002ELE6327XTMA1
D15: Schottky; TSSLP-2-1; Part Number JDH2S02SL,L3F
L4, L5, L26: 100 uH; L_TDK_MLZ2012_h1.25mm; Part Number MLZ2012N101LT000
L12, L31, L32: 56 nH; L_0201_0603Metric; Part Number LQP03TN56NJ02D
L13: 2.2 uH; L_0603_1608Metric; Part Number LSQPB160807T2R2M
L19: 47 uH; L_Taiyo-Yuden_A251818; Part Number LSQEA251818T470M
P3: SMA; SMA_MyAntenna_A-SMA-KE-16.5A_EdgeMount; Part Number A-SMA-KE-16.5A
Q1: NMOS/PMOS; SOT-563; Part Number DMC2400UV-7
R20: 180k; R_0402_1005Metric; Tolerance ±1%; Part Number RC0402FR-07180KL
R29: 100; R_0201_0603Metric; Part Number RC0201JR-07100RL
R35, R114, R129, R153, R154: 1k; R_0201_0603Metric; Part Number RC0201FR-071KL
R36: 10k; R_0402_1005Metric; Part Number RC0402JR-0710KL
R42, R131, R146: 220; R_0201_0603Metric; Part Number RC0201JR-07220RL; not fitted
R115, R116, R117: 470; R_0201_0603Metric; Part Number RC0201JR-07470RL
R126: 4.7k; R_0201_0603Metric; Part Number RC0201FR-074K7L
R128: 220; R_0201_0603Metric; Part Number RC0201JR-07220RL
R152: 3; R_0201_0603Metric; Part Number RC0201JR-073RL
TP47: TestPoint; TestPoint_Pad_D1.0mm
U12, U14: MXD8638C; Part Number MXD8638C
U13: 74LVC1G86; SOT-353_SC-70-5; Part Number SN74LVC1G86DCKR
U24: AP22652; TSOP-6_1.65x3.05mm_P0.95mm; Part Number AP22652W6-7
U25: TRF37C73; WSON-8-1EP_2x2mm_P0.5mm_EP0.9x1.6mm; Part Number TRF37C73IDSGR
U40: BGB741L7ESD; TSLP-7-1; Part Number BGB741L7ESDE6327XTSA1

Connections:
2V5RF: C60.1, C66.1, C95.1, Q1.4 (S), U12.7 (VDD), U14.7 (VDD)
AMP_BYPASS: U12.2 (RF3), U14.2 (RF3)
BIAS: D10.1 (K), L19.1, R35.1, R126.2, TP47.1
GND: C2.2, C4.1, C6.1, C52.2, C53.2, C55.1, C57.1, C60.2, C63.1, C65.1, C66.2, C69.2, C95.2, C160.2, C161.2, C171.2, C200.2, C201.2, C204.2, C206.2, C208.2, C209.2, D1.2 (A2), D14.2 (A), P3.2 (GND), Q1.1 (S), R20.2, R42.1, R126.1, R131.1, R146.1, U12.6 (GND), U12.9 (GND), U13.3 (GND), U14.6 (GND), U14.9 (GND), U24.2 (GND), U25.3 (NC), U25.4 (NC), U25.6 (NC), U25.8 (NC), U25.9 (GND), U40.7 (GND)
unnamed: C50.2, R152.1
unnamed: C53.1, L4.1, R116.2, U40.2 (BIAS)
unnamed: C58.2, L31.2, R115.1, R153.1, U40.3 (RFIN)
unnamed: C59.2, U25.2 (RFIN)
unnamed: C62.1, L12.2, R129.1, U25.7 (RFOUT)
unnamed: C64.1, C68.2, D14.1 (K), D15.2 (A)
unnamed: C64.2, D1.1 (A1), L13.2, P3.1 (RF)
unnamed: C68.1, U14.4 (ANT)
unnamed: C69.1, D15.1 (K), Q1.6 (D), R29.1
unnamed: C78.1, L32.2, R152.2, R154.1, U40.4 (RFOUT)
unnamed: C78.2, R115.2
unnamed: C112.1, R35.2
unnamed: C112.2, L13.1, L19.2
unnamed: C139.1, L12.1, L26.2, R128.1, R129.2
unnamed: C139.2, R131.2
unnamed: C171.1, D10.2 (A), U24.6 (OUT)
unnamed: C207.1, L5.2, L32.1, R117.1, R154.2
unnamed: C207.2, R146.2
unnamed: C210.1, L4.2, L31.1, R116.1, R153.2
unnamed: C210.2, R42.2
unnamed: Q1.3 (D), R29.2
unnamed: R20.1, U24.5 (ILIM)
unnamed: R114.1, U40.6 (ADJ)
RF: U12.4 (ANT)
RX_AMP_EN: U13.4, U40.5 (CTRL)
RX_AMP_IN: C58.1, U14.5 (RF2)
RX_AMP_OUT: C50.1, C209.1, U12.3 (RF1)
RX_EN: Q1.2 (G), Q1.5 (G)
TX_AMP_IN: C59.1, U12.5 (RF2)
TX_AMP_OUT: C62.2, U14.3 (RF1)
VAA: C2.1, C52.1, C160.1, C161.1, C200.1, C201.1, C204.1, C206.1, C208.1, L5.1, L26.1, R36.2, R114.2, R117.2, R128.2, U13.1, U13.5 (VCC), U24.1 (IN), U25.1 (VCC), U40.1 (VCC)
~BIAS_EN: R36.1, U24.3 (~EN)
~BIAS_OC: U24.4 (~OC)
~RX_AMP_EN: C6.2, C57.2, C65.2, U12.8 (V2), U13.2, U14.1 (V1)
~TX_AMP_EN: C4.2, C55.2, C63.2, U12.1 (V1), U14.8 (V2), U25.5 (PWDN)

Notes on the sheet:
current limit: 125 mA ±20%
