frood1168/hackrf-pro/image_reject.kicad_sch

## KiCad design image_reject.kicad_sch (2026-06-23)

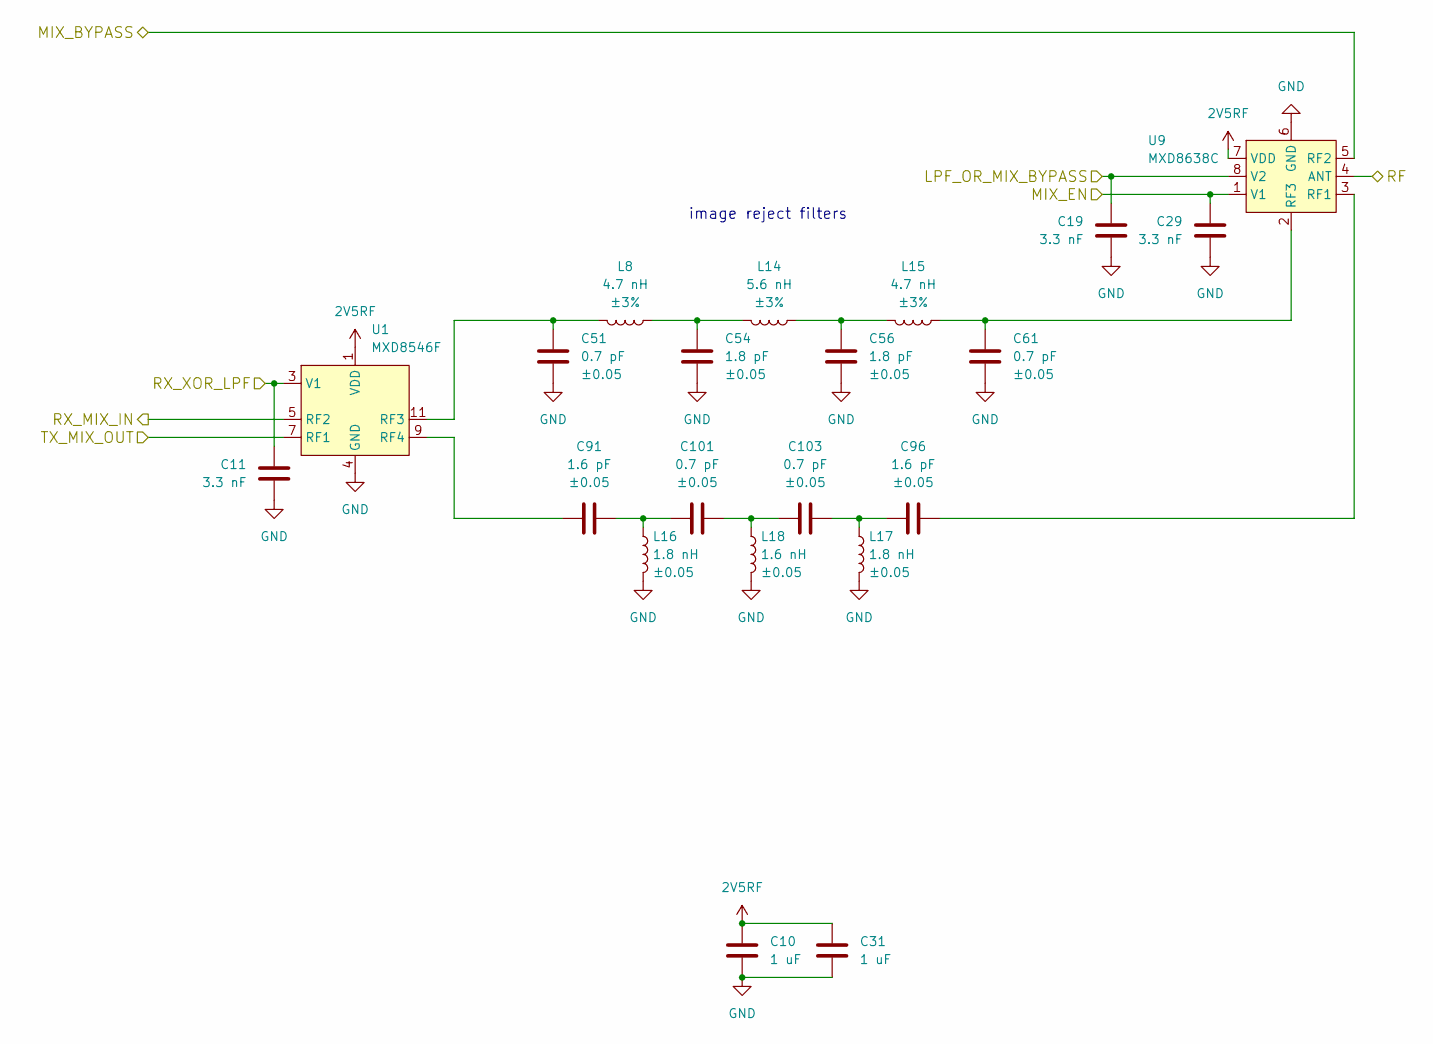
[picture p6: schematic image_reject.kicad_sch]

Parts:
C10, C31: 1 uF; C_0201_0603Metric; Part Number GRM033R61A105ME44D
C11, C19, C29: 3.3 nF; C_0201_0603Metric; Part Number GRM033R71A332KA01D
C51, C61, C101, C103: 0.7 pF; C_0201_0603Metric; Tolerance ±0.05; Part Number GRM0335C1ER70WA01D
C54, C56: 1.8 pF; C_0201_0603Metric; Tolerance ±0.05; Part Number GRM0335C1E1R8WA01D
C91, C96: 1.6 pF; C_0201_0603Metric; Tolerance ±0.05; Part Number GRM0335C1E1R6WA01D
L8, L15: 4.7 nH; L_0201_0603Metric; Tolerance ±3%; Part Number LQP03TN4N7H02D
L14: 5.6 nH; L_0201_0603Metric; Tolerance ±3%; Part Number LQP03TN5N6H02D
L16, L17: 1.8 nH; L_0201_0603Metric; Tolerance ±0.05; Part Number LQP03HQ1N8W02D
L18: 1.6 nH; L_0201_0603Metric; Tolerance ±0.05; Part Number LQP03HQ1N6W02D
U1: MXD8546F; QFN-12-1EP_2x2mm_P0.5mm_EP1x1mm; Part Number MXD8546F
U9: MXD8638C; Part Number MXD8638C

Connections:
2V5RF: C10.1, C31.1, U1.1 (VDD), U9.7 (VDD)
GND: C10.2, C11.1, C19.1, C29.1, C31.2, C51.2, C54.2, C56.2, C61.2, L16.2, L17.2, L18.2, U1.4 (GND), U1.6 (GND), U1.10 (GND), U1.12 (GND), U1.13 (GND), U9.6 (GND), U9.9 (GND)
LPF_OR_MIX_BYPASS: C19.2, U9.8 (V2)
MIX_BYPASS: U9.5 (RF2)
MIX_EN: C29.2, U9.1 (V1)
unnamed: C51.1, L8.2, U1.11 (RF3)
unnamed: C54.1, L8.1, L14.2
unnamed: C56.1, L14.1, L15.2
unnamed: C61.1, L15.1, U9.2 (RF3)
unnamed: C91.1, U1.9 (RF4)
unnamed: C96.2, U9.3 (RF1)
unnamed: C91.2, C101.1, L16.1
unnamed: C101.2, C103.1, L18.1
unnamed: C96.1, C103.2, L17.1
RF: U9.4 (ANT)
RX_MIX_IN: U1.5 (RF2)
RX_XOR_LPF: C11.2, U1.3 (V1)
TX_MIX_OUT: U1.7 (RF1)

Notes on the sheet:
image reject filters
