frood1168/hackrf-pro/power.kicad_sch

## KiCad design power.kicad_sch (2026-06-23)

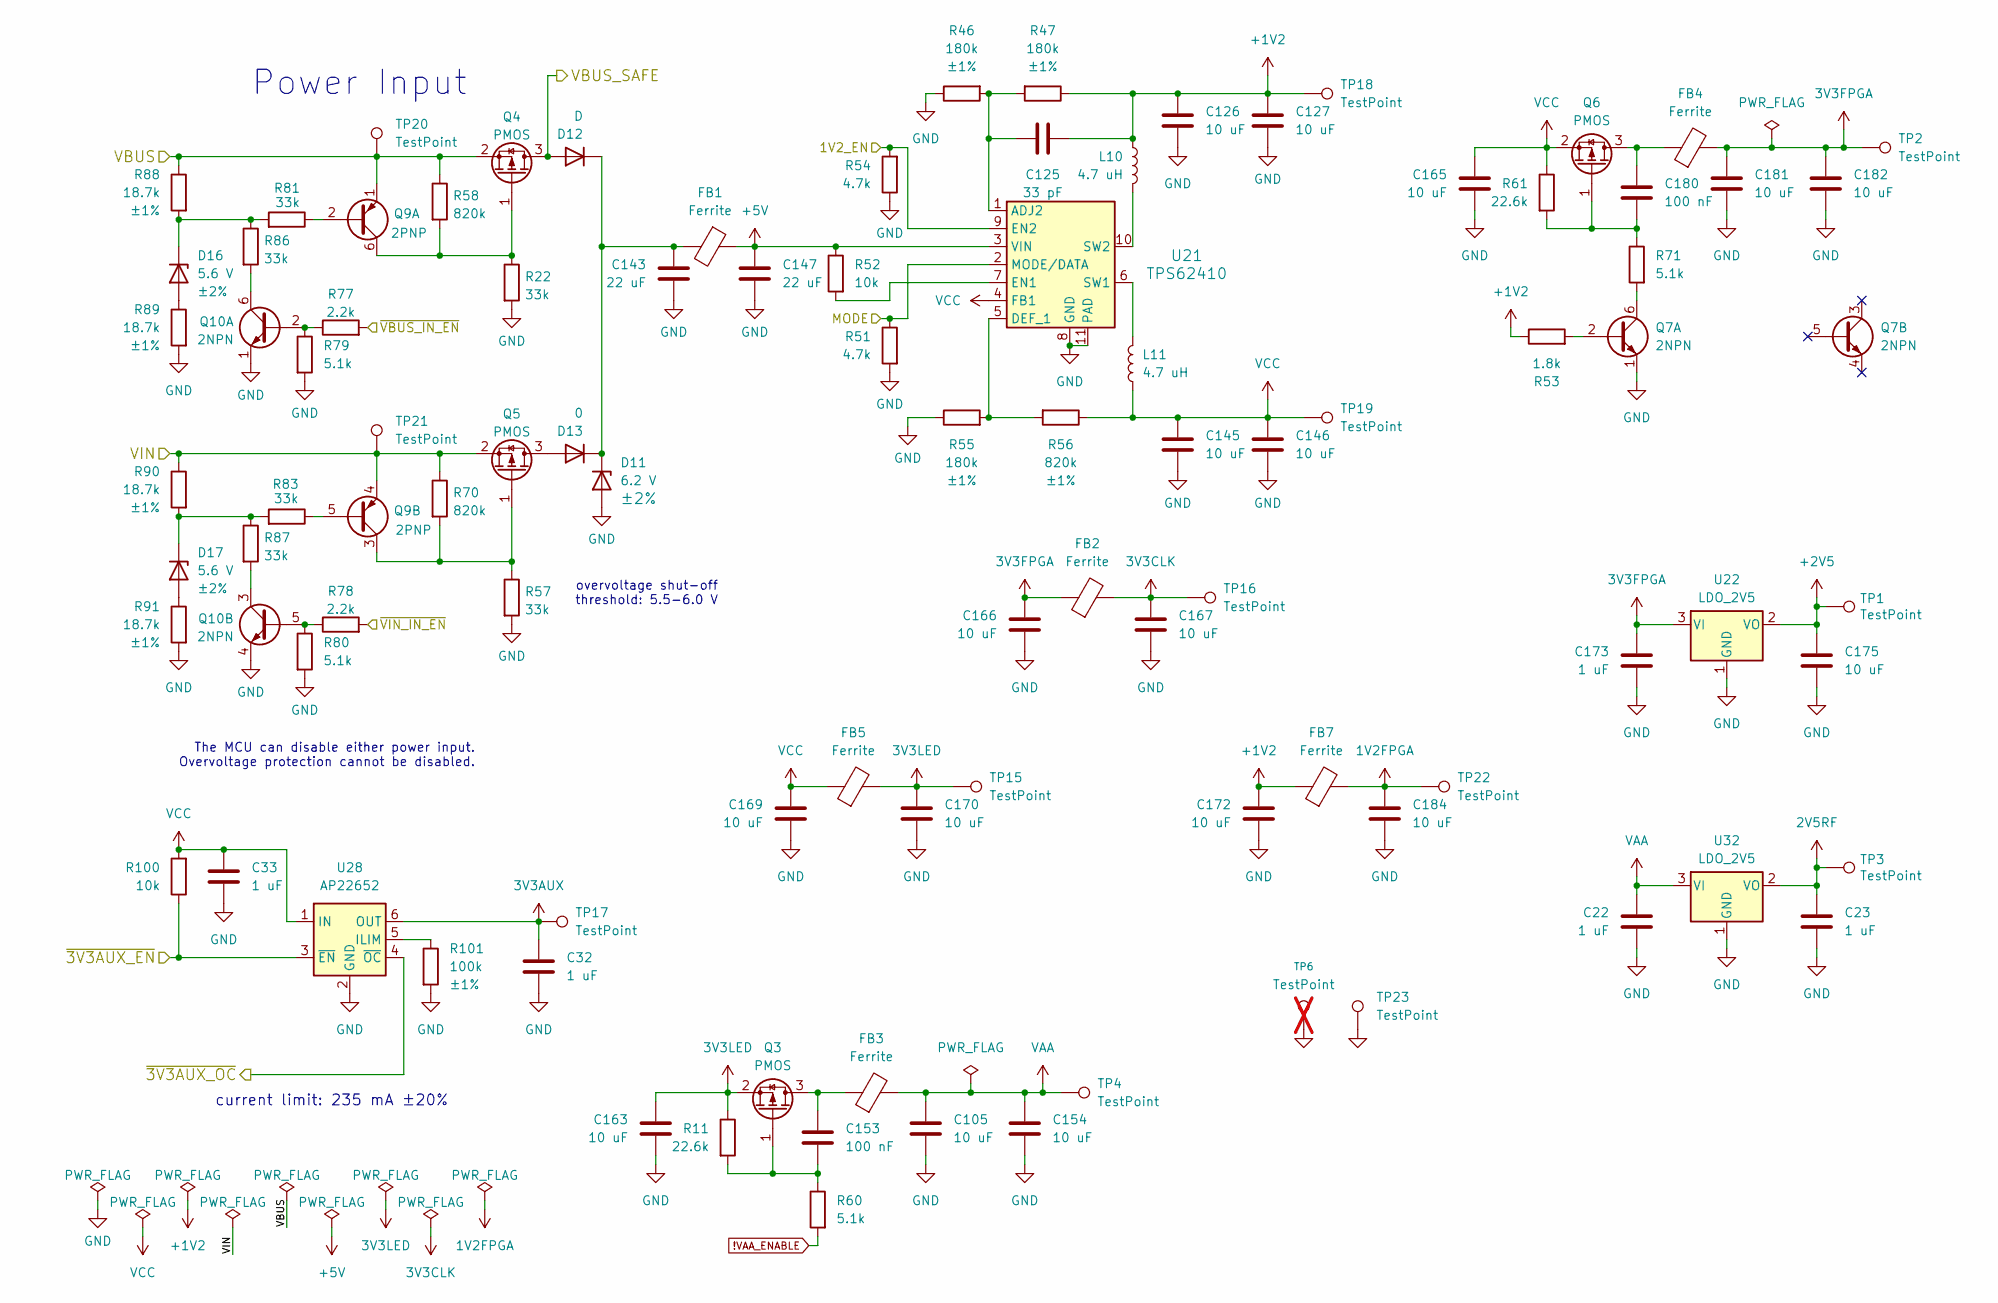
[picture p10: schematic power.kicad_sch]

Parts:
C22, C23, C32, C33, C173: 1 uF; C_0402_1005Metric; Part Number CL05A105KA5NQNC
C105, C126, C127, C145, C146, C154, C163, C165, C166, C167, C169, C170, C172, C175, C181, C182, C184: 10 uF; C_0805_2012Metric; Part Number CL21A106KOQNNNE
C125: 33 pF; C_0201_0603Metric; Part Number GRM0335C1H330JA01D
C143, C147: 22 uF; C_0805_2012Metric; Part Number CL21A226MAYNNNE
C153, C180: 100 nF; C_0402_1005Metric; Part Number CL05A104KA5NNNC
D11: 6.2 V; TSLP-2-19; Tolerance ±2%; Part Number BZX884-B6V2,315
D12: D; D_SOD-123FL; Part Number U1D
D13: 0; TSLP-2-19; Part Number RC0201JR-070RL
D16, D17: 5.6 V; TSLP-2-19; Tolerance ±2%; Part Number BZX884-B5V6,315
FB1, FB2, FB3, FB4, FB5, FB7: Ferrite; L_0603_1608Metric; Part Number HCB1608KF-102T10
L10, L11: 4.7 uH; L_Taiyo-Yuden_NR-40xx; Part Number LSXND4040TKL4R7MDG
Q3, Q4, Q5, Q6: PMOS; SOT-23-3; Part Number YJL3401A
Q7, Q10: 2NPN; SOT-363_SC-70-6; Part Number BC847BS
Q9: 2PNP; SOT-363_SC-70-6; Part Number BC857BS
R11, R61: 22.6k; R_0201_0603Metric; Part Number RC0201FR-0722K6L
R22, R57, R81, R83, R86, R87: 33k; R_0201_0603Metric; Part Number RC0201JR-0733KL
R46, R47, R55: 180k; R_0402_1005Metric; Tolerance ±1%; Part Number RC0402FR-07180KL
R51, R54: 4.7k; R_0201_0603Metric; Part Number RC0201FR-074K7L
R52, R100: 10k; R_0402_1005Metric; Part Number RC0402JR-0710KL
R53: 1.8k; R_0402_1005Metric; Part Number RC0402JR-071K8L
R56: 820k; R_0402_1005Metric; Tolerance ±1%; Part Number RC0402FR-07820KL
R58, R70: 820k; R_0402_1005Metric; Part Number RC0402FR-07820KL
R60, R71, R79, R80: 5.1k; R_0402_1005Metric; Part Number RC0402JR-075K1L
R77, R78: 2.2k; R_0201_0603Metric; Part Number RC0201JR-072K2L
R88, R89, R90, R91: 18.7k; R_0402_1005Metric; Tolerance ±1%; Part Number RC0402FR-0718K7L
R101: 100k; R_0402_1005Metric; Tolerance ±1%; Part Number RC0402FR-07100KL
TP1, TP2, TP3, TP4, TP15, TP16, TP17, TP18, TP19, TP20, TP21, TP22, TP23: TestPoint; TestPoint_Pad_D1.0mm
TP6: TestPoint; TestPoint_Loop_D1.80mm_Drill1.0mm_Beaded; Part Number RH-5001; not fitted
U21: TPS62410; Texas_S-PVSON-N10_ThermalVias; Part Number TPS62410DRCR
U22, U32: LDO_2V5; SOT-23-3; Part Number XC6206P252MR
U28: AP22652; TSOP-6_1.65x3.05mm_P0.95mm; Part Number AP22652W6-7

Connections:
1V2FPGA: C184.1, FB7.2, TP22.1
1V2_EN: R54.2, U21.9 (EN2)
2V5RF: C23.1, TP3.1, U32.2 (VO)
3V3AUX: C32.1, TP17.1, U28.6 (OUT)
3V3CLK: C167.1, FB2.2, TP16.1
3V3FPGA: C166.1, C173.1, C181.1, C182.1, FB2.1, FB4.2, TP2.1, U22.3 (VI)
3V3LED: C163.1, C170.1, FB5.2, Q3.2 (S), R11.1, TP15.1
!VAA_ENABLE: R60.2
+1V2: C125.1, C126.1, C127.1, C172.1, FB7.1, L10.2, R47.1, R53.1, TP18.1
+2V5: C175.1, TP1.1, U22.2 (VO)
+5V: C147.1, FB1.1, R52.1, U21.3 (VIN)
GND: C22.2, C23.2, C32.2, C33.2, C105.2, C126.2, C127.2, C143.2, C145.1, C146.1, C147.2, C154.2, C163.2, C165.2, C166.2, C167.2, C169.2, C170.2, C172.2, C173.2, C175.2, C181.2, C182.2, C184.2, D11.2 (A), Q7.1 (E1), Q10.1 (E1), Q10.4 (E2), R22.2, R46.1, R51.2, R54.1, R55.1, R57.2, R79.2, R80.2, R89.2, R91.2, R101.2, TP6.1, TP23.1, U21.8 (GND), U21.11 (PAD), U22.1 (GND), U28.2 (GND), U32.1 (GND)
MODE: R51.1, U21.2 (MODE/DATA)
unnamed: C125.2, R46.2, R47.2, U21.1 (ADJ2)
unnamed: C143.1, D11.1 (K), D12.1 (K), D13.1 (K), FB1.2
unnamed: C153.1, Q3.1 (G), R11.2, R60.1
unnamed: C153.2, FB3.1, Q3.3 (D)
unnamed: C180.1, Q6.1 (G), R61.2, R71.1
unnamed: C180.2, FB4.1, Q6.3 (D)
unnamed: D13.2 (A), Q5.3 (D)
unnamed: D16.1 (K), R81.2, R86.1, R88.2
unnamed: D16.2 (A), R89.1
unnamed: D17.1 (K), R83.2, R87.1, R90.2
unnamed: D17.2 (A), R91.1
unnamed: L10.1, U21.10 (SW2)
unnamed: L11.2, U21.6 (SW1)
unnamed: Q4.1 (G), Q9.6 (C1), R22.1, R58.2
unnamed: Q5.1 (G), Q9.3 (C2), R57.1, R70.2
unnamed: Q7.2 (B1), R53.2
unnamed: Q7.6 (C1), R71.2
unnamed: Q9.2 (B1), R81.1
unnamed: Q9.5 (B2), R83.1
unnamed: Q10.2 (B1), R77.1, R79.1
unnamed: Q10.3 (C2), R87.2
unnamed: Q10.5 (B2), R78.1, R80.1
unnamed: Q10.6 (C1), R86.2
unnamed: R52.2, U21.7 (EN1)
unnamed: R55.2, R56.2, U21.5 (DEF_1)
unnamed: R101.1, U28.5 (ILIM)
VAA: C22.1, C105.1, C154.1, FB3.2, TP4.1, U32.3 (VI)
VBUS: Q4.2 (S), Q9.1 (E1), R58.1, R88.1, TP20.1
VBUS_SAFE: D12.2 (A), Q4.3 (D)
VCC: C33.1, C145.2, C146.2, C165.1, C169.1, FB5.1, L11.1, Q6.2 (S), R56.1, R61.1, R100.2, TP19.1, U21.4 (FB1), U28.1 (IN)
VIN: Q5.2 (S), Q9.4 (E2), R70.1, R90.1, TP21.1
~3V3AUX_EN: R100.1, U28.3 (~EN)
~3V3AUX_OC: U28.4 (~OC)
~VBUS_IN_EN: R77.2
~VIN_IN_EN: R78.2

Notes on the sheet:
current limit: 235 mA ±20%
overvoltage shut-off threshold: 5.5-6.0 V
Power Input
The MCU can disable either power input. Overvoltage protection cannot be disabled.
