frood1168/hackrf-pro/praline.kicad_sch

## KiCad design praline.kicad_sch (2026-06-23)

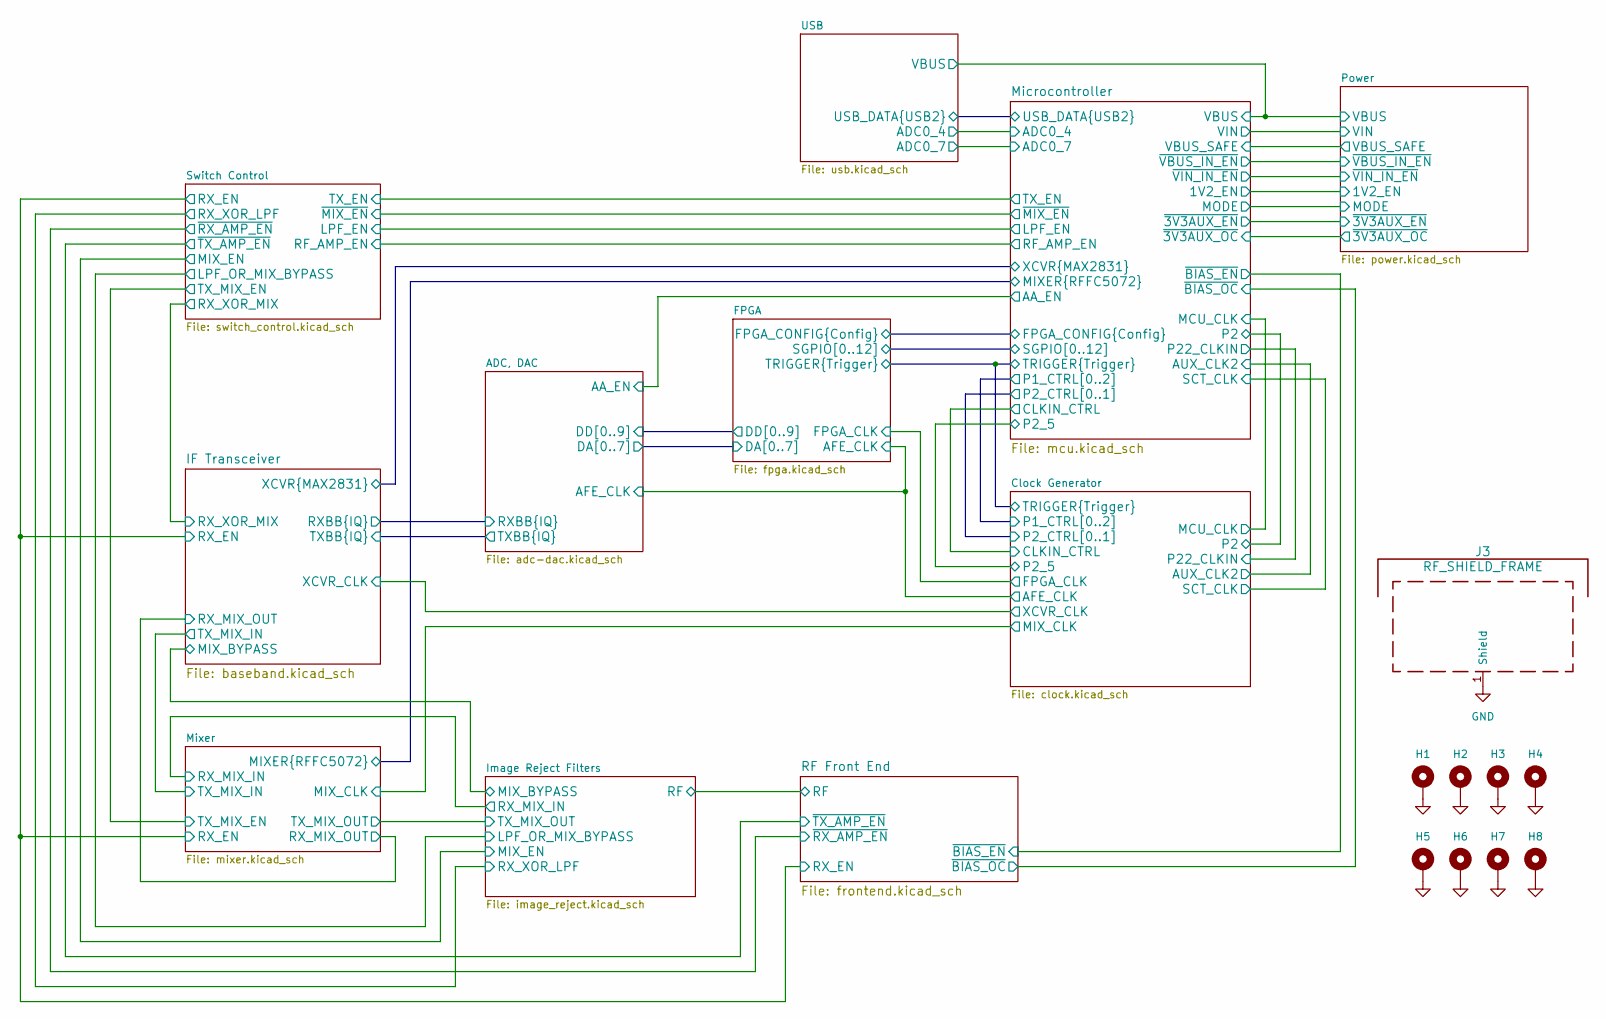
[picture p11: schematic praline.kicad_sch]

Parts:
H1, H2, H3, H4: MountingHole_Pad; MountingHole_3.2mm_M3_Pad_Via
H5, H6, H7, H8: MountingHole_Pad; MountingHole_2.2mm_M2_Pad_Via
J3: RF_SHIELD_FRAME; Laird_Technologies_BMI-S-230-F_50.8x38.1mm; Part Number 2118732-2

Connections:
GND: H1.1, H2.1, H3.1, H4.1, H5.1, H6.1, H7.1, H8.1, J3.1
