frood1168/hackrf-pro/(commit log)

2026-05-01 After initial processing of sources. SCH and PCB are passing validation and PCB rules settings based on the KiCad reference design. TODO: Setup the layer stack proper, and configure impedance matched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
    [adc-dac.SchDoc, baseband.SchDoc, clock.SchDoc, fpga.SchDoc, frontend.SchDoc, image_reject.SchDoc, mcu.SchDoc, mixer.SchDoc]
2026-05-01 After initial processing of sources. SCH and PCB are passing validation and PCB rules settings based on the KiCad reference design. TODO: Setup the layer stack proper, and configure impedance matched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
2026-05-01 After initial processing of sources. SCH and PCB are passing validation and PCB rules settings based on the KiCad reference design. TODO: Setup the layer stack proper, and configure impedance matched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
2026-06-23 sync review of hardware
    [adc-dac.SchDoc, adc-dac.kicad_sch, baseband.SchDoc, baseband.kicad_sch, clock.SchDoc, clock.kicad_sch, fpga.SchDoc, fpga.kicad_sch]
